RyugaWork/IOT_SU26-Smark-parking-system-with-AI-and-Dashboard/Code/SmartParkingYOLO/testcase/runs/detect/predict/test.jpg

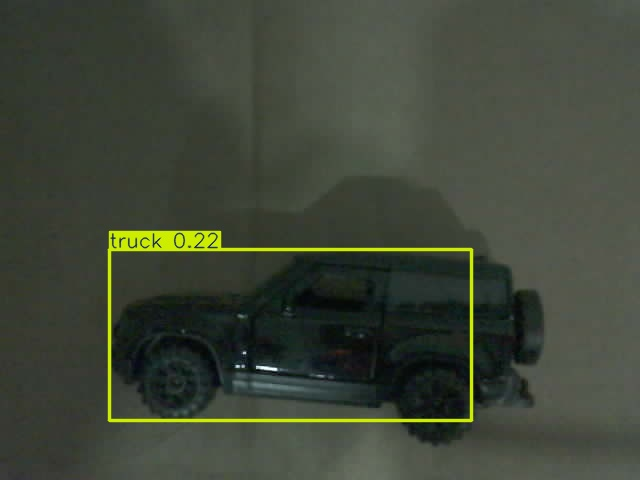
Code/SmartParkingYOLO/testcase/runs/detect/predict/test.jpg
