RyugaWork/IOT_SU26-Smark-parking-system-with-AI-and-Dashboard/Code/SmartParkingYOLO/testcase/001.jpg

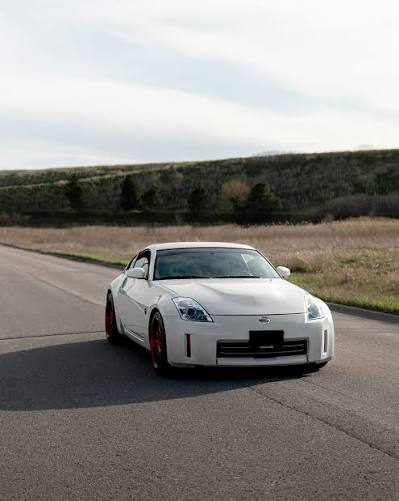
Code/SmartParkingYOLO/testcase/001.jpg
