RyugaWork/IOT_SU26-Smark-parking-system-with-AI-and-Dashboard/History/ProposalLayout.drawio.png

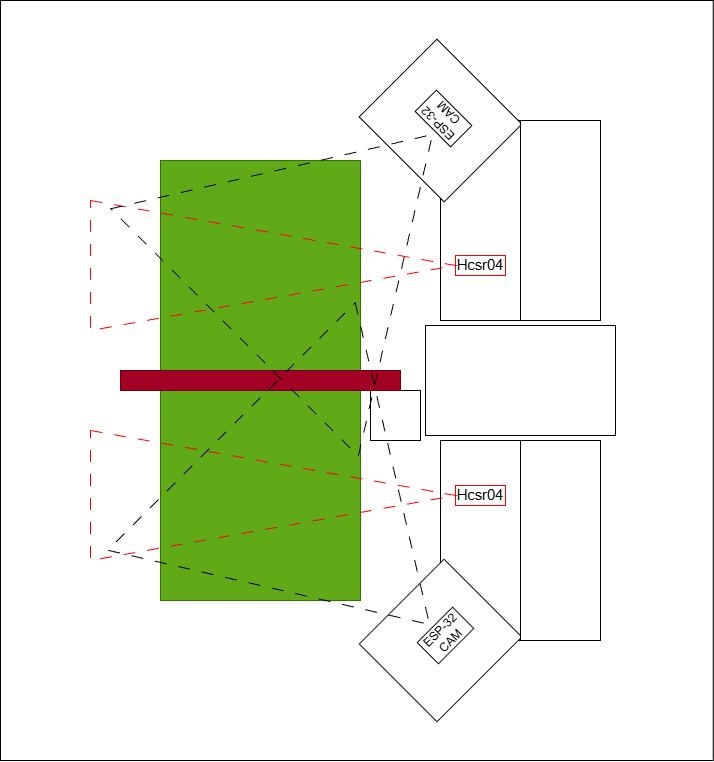
History/ProposalLayout.drawio.png
