RyugaWork/IOT_SU26-Smark-parking-system-with-AI-and-Dashboard/Code/SmartParkingYOLO/results/latest_annotated.jpg

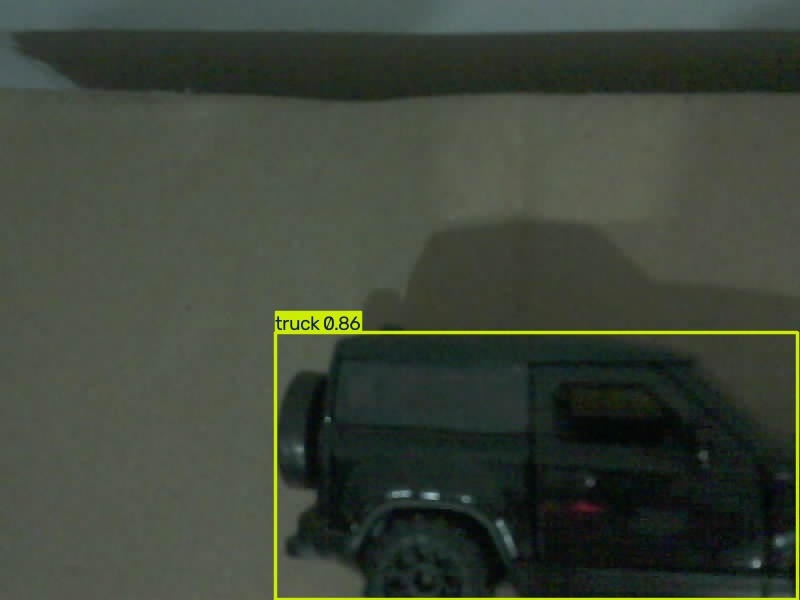
Code/SmartParkingYOLO/results/latest_annotated.jpg
