RyugaWork/IOT_SU26-Smark-parking-system-with-AI-and-Dashboard/Code/SmartParkingYOLO/testcase/003.jpg

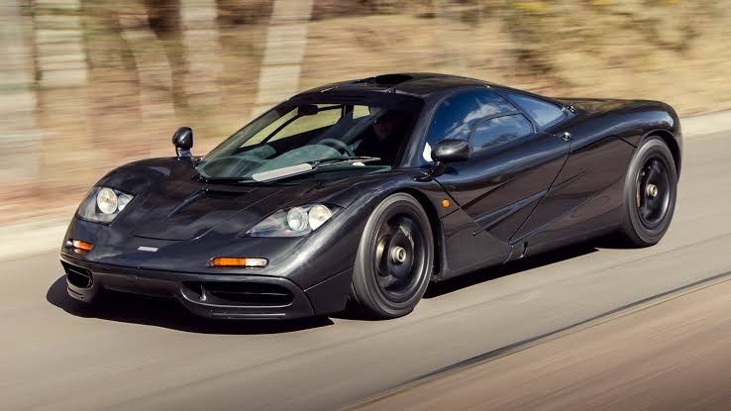
Code/SmartParkingYOLO/testcase/003.jpg
