RyugaWork/IOT_SU26-Smark-parking-system-with-AI-and-Dashboard/Code/SmartParkingYOLO/testcase/runs/detect/predict-3/test.jpg

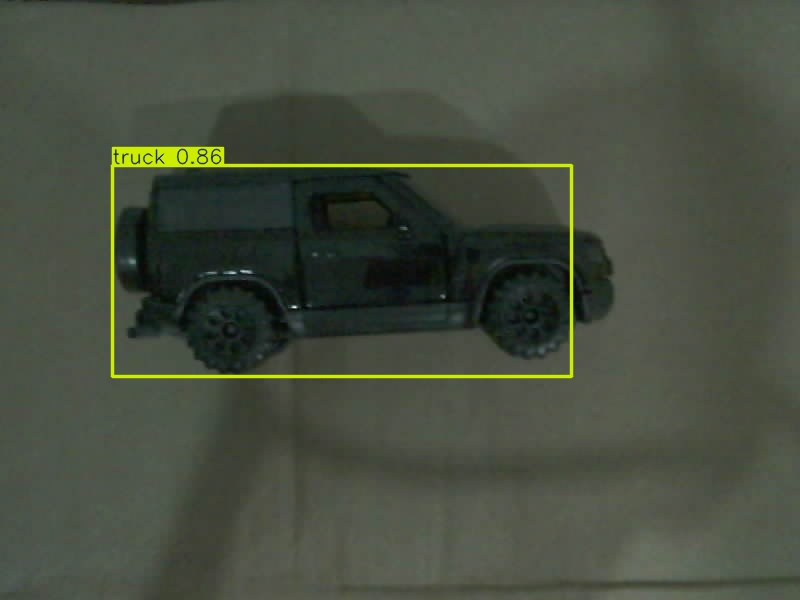
Code/SmartParkingYOLO/testcase/runs/detect/predict-3/test.jpg
