RyugaWork/IOT_SU26-Smark-parking-system-with-AI-and-Dashboard/History/Documents/IOT_Project_Documents_v0.1.0.docx

A Smart Parking System

IOT102-SE2045, GROUP 7

Nguyen Sy Minh Man, Do Thanh Triet, Tran Dang Khoa, and Bui Dinh Long

FPT University, Ho Chi Minh Campus, Vietnam

{syminhman01, thanhtriet1007, khoavainoi2398, buidinhlongwork}@gmail.com

Abstract—This project presents a Smart Parking System with vehicle detection, barrier control, and web-based monitoring. The system integrates Arduino UNO R3 boards, ultrasonic sensors, an ESP32-CAM, a servo-based barrier, an IR remote, a backend server, and a web dashboard. The ultrasonic sensors are used to detect vehicle presence near the parking gate, while the Arduino UNO boards handle sensor communication and barrier control. When a vehicle is detected, the ESP32-CAM captures an image and sends it to the backend server for vehicle detection or license plate recognition. Based on the detection result, the system determines whether the barrier should be opened or remain closed. The IR remote provides manual override functions, allowing the operator to open, close, or reset the barrier when necessary. The web dashboard displays gate status, sensor readings, captured images, detection results, and vehicle entry or exit history. The proposed system demonstrates an IoT-based parking management solution that improves automation, monitoring, and control compared with traditional manual parking systems.

Keywords: Internet of Things, IoT, Smart Parking, Arduino UNO, ESP32-CAM, Ultrasonic Sensor, Barrier Control, Web Dashboard, Vehicle Detection.

# VERSION HISTORY

Date | Description | Note | Version
##/##/## | | | v#.#.#

08/06/26 | Initialize Document | | v0.1.0

# I. INTRODUCTION

A. Background

B. Problem Statement

II. SYSTEM DESIGN
A. Hardware Design
B. Software Design
C. System Workflow

III. IMPLEMENTATION

IV. RESULTS AND DISCUSSION

V. CONCLUSION

REFERENCES
