RyugaWork/IOT_SU26-Smark-parking-system-with-AI-and-Dashboard/History/BlockDiagram/Block_Diagram_v26.0608.jpg

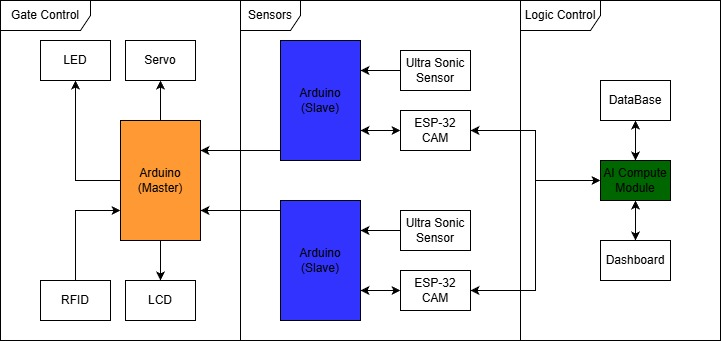
History/BlockDiagram/Block_Diagram_v26.0608.jpg
