RyugaWork/IOT_SU26-Smark-parking-system-with-AI-and-Dashboard/History/BlockDiagram/BlockDiagram_v26.0605.jpg

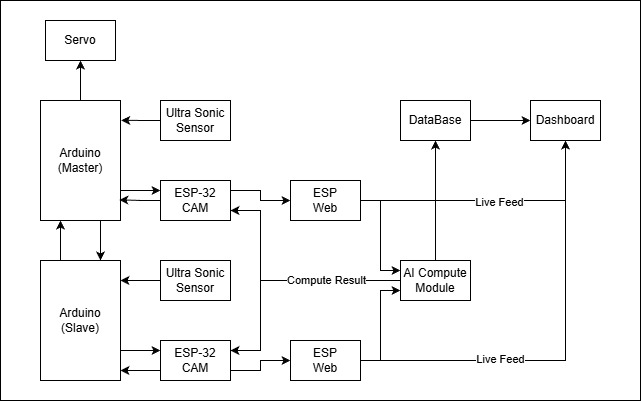
History/BlockDiagram/BlockDiagram_v26.0605.jpg
