RyugaWork/IOT_SU26-Smark-parking-system-with-AI-and-Dashboard/History/Flowchart/FlowChart_Detection&OpenGate_v26.0605.jpg

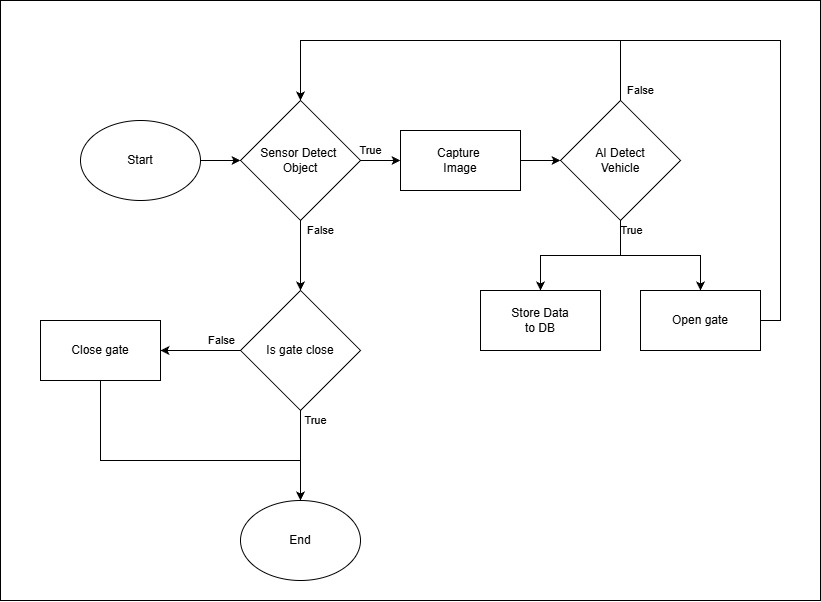
History/Flowchart/FlowChart_Detection&OpenGate_v26.0605.jpg
