RyugaWork/IOT_SU26-Smark-parking-system-with-AI-and-Dashboard/(commit log)

2026-06-05 Feat - Adding Report Material
    Adding BlockDiagram v26.0605 and Detection&GateOpen Flowchart v26.0605
2026-06-08 Update - Block Diagram
    - BlockDiagram_v26.0608
    + Add Arduino act as master to control the gate
    + Add LED, LCD and RFID
    + Old master arduino now server as a slave
2026-06-08 Feat - FlowCharts
    - Move FlowChart_Detection&OpenGate to History
    + Arduino Master flowchart
    + Gate Control Processes flowchart
2026-06-08 Đổi tên
2026-06-08 Feat - Arduino Code
    + Master Code
    + Slave Code
2026-07-13 Feat & Change
    Add final arduino & esp32 cam codes.
    Move old code to .old
    Move old files to History
2026-07-15 Feat & Changes
    + Report material & RBL
    | Readme.md
    | Move old documents to history
    | Change code folder structure
